RDoughBoy/RDoughBoy.github.io/images/PI_LED_BLINK.jpg

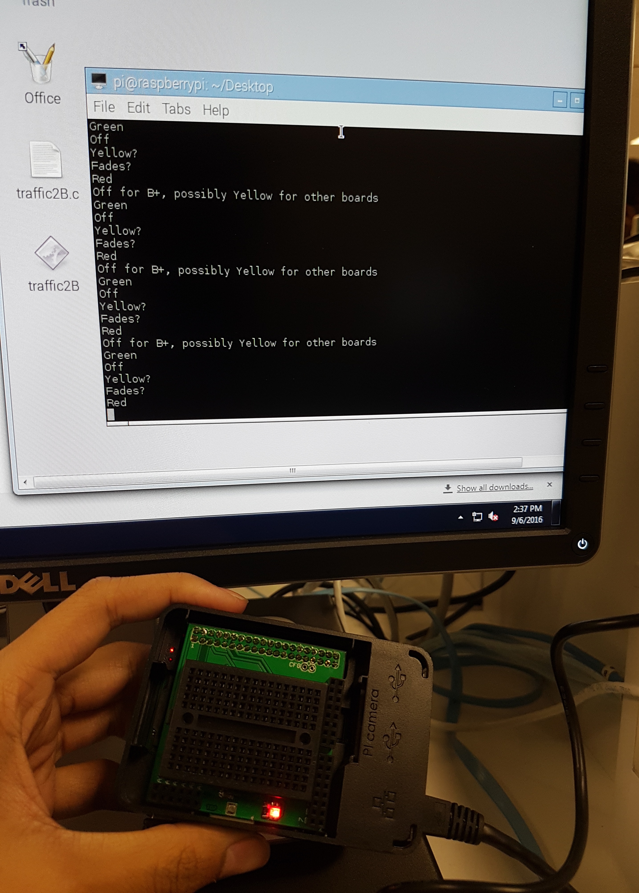
images/PI_LED_BLINK.jpg
