RDoughBoy/RDoughBoy.github.io/images/PlacardLifelines.jpg

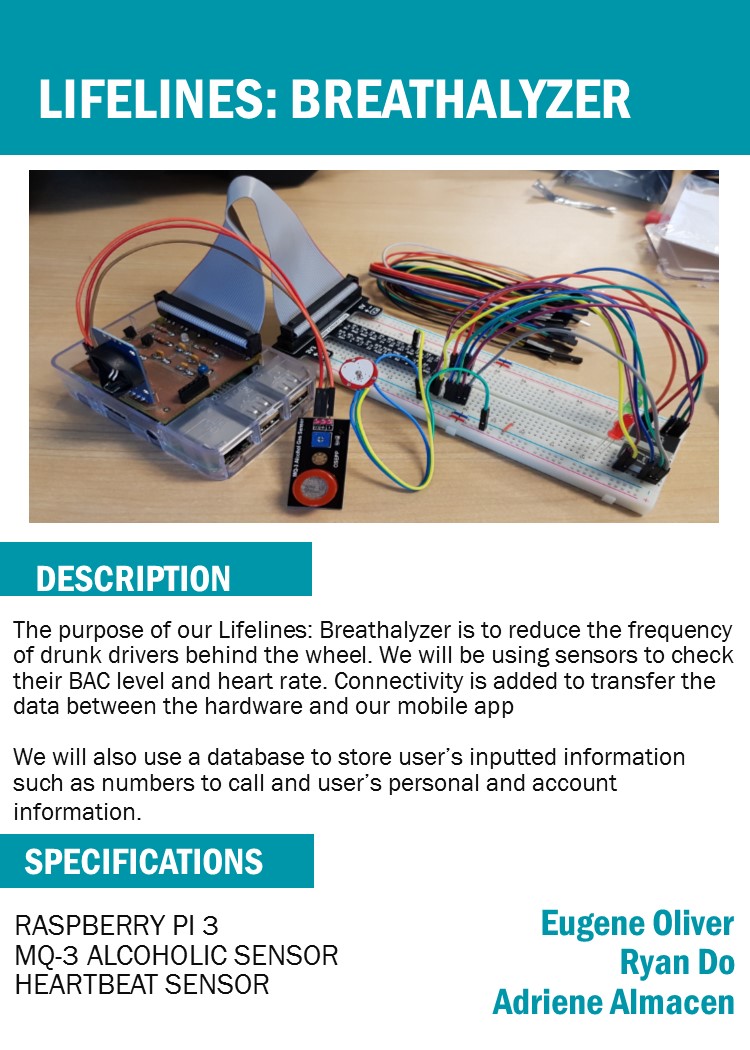
images/PlacardLifelines.jpg
