RDoughBoy/RDoughBoy.github.io/images/Schematic.png

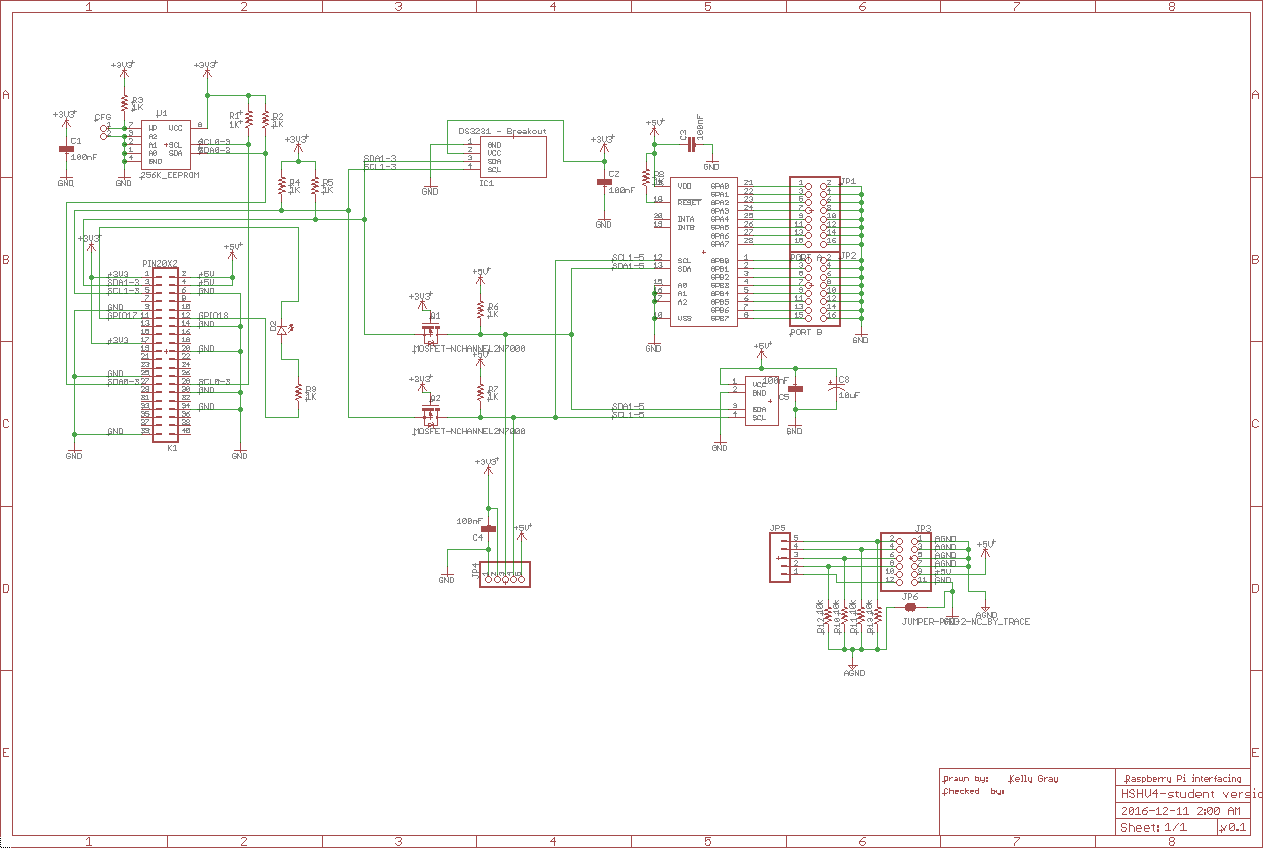
images/Schematic.png
