RDoughBoy/RDoughBoy.github.io/documents/Budget.xlsx

Hardware Project Budget September 27, 2016
Ryan Do - N01044391
Name of Item | Description | Supplier/Part Number | Price/Unit | Qty. | Taxes/Shipping/Customs
CanaKit Raspberry Pi 3 Ultimate Starter Kit - 32 GB Edition | Includes Raspberry Pi 3, 32GB micro SD with NOOBS, Case, GPIO to Breadboard, etc | Amazon.ca/B01CCF9BYG | $119.99 | 1 | $15.60
OSEPP MQ-3 Alcohol Gas Sensor Module | Alcohol Gas Sensor | Amazon.ca/B01ISMV6G8 | $11.95 | 1 | $1.55
Sparkykit XD-58C Pulsesensor Pulse Heart Rate Sensor | Heart Rate Sensor | Amazon.ca/B01AUVMFIS | $18.99 | 1 | $4.34
SODIAL(R) 5 Pcs Common Anode 12 Pin 3 Bit 7 Segment 0.28" Red LED Display | 7 Segment LED Display | Amazon.ca/B00IIDXCGA | $2.92 | 1 | $0.00
Humber Parts Kit |  | Humber College | $120 | 1 | $0.00
Resistors | Inlcuded in Parts Kit
Capacitors | Inlcuded in Parts Kit
LEDs | Inlcuded in Parts Kit
Wires | Inlcuded in Parts Kit
PCB Kit |  | Humber College | $40 | 1 | $0.00
 |  | Subtotal | $313.85
 |  | Final Total | $335.34
