RDoughBoy/RDoughBoy.github.io/(commit log)

2016-09-06 Pi Blinking LED
2016-11-08 Added Progress Report
    [Budget.xlsx]
2016-12-11 updated build log with python code
    [HSHV4-student version.brd, HSHV4-student version.sch]
2016-12-11 fixed board picture
